soggybag/Ugly-Face-3-SMD/docs/v1.3 Envelope.md

# Ugly Face 3 v1.3: new envelope (design, 2026-10-16)

**Schematic: drawn (2026-10-16), rev 1.3, ERC 0.** Envelope detector at the top of ENVELOPE & GATE; U5B / Q1 / vactrol in the new VACTROL DRIVER box; D6 BAT54S on RESET; R21 15k; R13 220k. **PCB: updated 2026-10-19** (v1.1 layout kept; the envelope parts are added in the space freed by R7 / C8, mainly right of U2). Fully routed (46 vias), DRC 0 errors, parity clean; JLC files in `production/` (64 placements, 37 BOM lines). Also in v1.3: the Taiway 100 footprint with plated slots (v1.1 holes were too small for the flat lugs), R31/R32 on the Basic 100k (C149504).

**Before ordering:** the new envelope hasn't been breadboarded yet (see *Next step* below). The board follows the simulated design; the DECAY trimmer and C20 are the knobs to tune afterwards.

**Build notes (v1.3):**
- **RV6** (DECAY, 3362P 500k, front top-right): its leads come through under the MIX pot body on the back. Trim them flush, as for the vactrol and J1/J2.
- **Vactrol polarity:** U3 pin 1 = LED anode (long leg, to R35 / +9V), pin 2 = cathode (to Q1). v1.1 drove it the other way round from the pot.
- **R31, R32, R34** have no reference on the silkscreen (no room); see the interactive BOM.
- **JLC viewer:** check U1, U2, U4, U5 (SOIC-8) and D6, Q1 (SOT-23). Other boards this month needed SOIC op-amps turned 90° clockwise and SOT-23 transistors 180°. C1 / C4 already carry a 180° offset.
- **Extended parts:** TLC555 (C6987), 100µ C970685, BAT54S C19726 (new), R8 56k C17756 (was Basic; JLC moved it).

## Bench result (2026-10-23)

Built on a breadboard and wired to unit 1 (DRY_OUT tap = the same buffered dry signal v1.3 uses): **works**. C21 3.3µ sounded best (smoother envelope, less ripple on low notes, attack ~3 ms, DECAY range ~0.07–1.7 s). On the board: **C21 = 4.7µ 0805 X5R (C1779, same as C17)**, about 3µ at its 4.5–7 V DC bias. RV6 stays a trimmer (players may want to adjust DECAY). Also for v1.3: R8 56k → 47k (Basic; GLITCH trim point moves to ~60% of RV2). The pedal is renamed **FU-2**.

## Why the v1.1 envelope is weak

- The vactrol LED is fed from **PRE_OUT** (R7 100 Ω → C8 100µ → ENVELOPE RV1 B1k → LED), the ×201 preamp **after it clips**. Every note is the same ~7 Vpp square, so loudness information is mostly gone: what's left is how long a note keeps clipping.
- The LED only conducts on the positive half-cycle, and only above its ~1.8 V forward voltage. With the pot as a divider, nothing happens below ~50 % of the rotation.
- Bench tests (2026-10-15/16) of rewiring RV1 as a rheostat, with a diode or a 2k2 for C8's DC return: too strong or too weak. The drive itself has to change. Full background: `../Ugly Face Roadmap.md` → *Envelope: string balance*.

## New circuit (roadmap option A, simplified for UF3)

UF3 already has a **clean** copy of the guitar: **DRY_OUT** (U4A, ×4.3). The new envelope is taken from it, so the preamp and gate are untouched. One **LM358** and one transistor are added.

```
DRY_OUT ─ C20 33n ─ R26 10k ─┬─ RV1 pin 3          ENVELOPE = A10k level control (pin 1 to VB)
                             RV1 (A10k)             tilt: 33n with 20k → ~240 Hz high-pass
                     VB ─────┴─ RV1 pin 1           (evens out low E vs thin strings)
                 RV1 wiper ──► U5A +  (pin 3)

U5A: peak detector with gain ×22
   out (pin 1) ─ D5 1N4148W ─ R27 1k ─┬─ ENV ── C21 1µ ─ GND        attack ~1 ms
                                      ├─ R28 470k ─ U5A − (pin 2) ── R29 22k ─ VB
                                      └─ R30 22k ─ RV6 500k trim ─ VB        DECAY ~20–250 ms

U5B + Q1: current sink for the vactrol LED, I_LED ≈ 2.1 × (ENV − VB − 0.2 V) / 330 Ω
   ENV ─ U5B + (pin 5)
   U5B − (pin 6) ── R31 100k ─ +9V,  R36 1M ─ +9V,  R32 100k ─ Q1 emitter
   U5B out (pin 7) ─ R33 1k ─ Q1 base (MMBT3904)
   Q1 emitter ─ R34 330 ─ GND
   +9V ─ R35 100 ─ vactrol LED anode (U3 pin 1);  LED cathode (U3 pin 2) ─ Q1 collector
```

### How it works

- **Tilt:** C20 / R26 + RV1 form a ~240 Hz high-pass. That takes ~8–10 dB off the low E fundamental, so the thin strings drive the envelope about as hard as the low E. The 10k / 10k divider also halves the signal, keeping U5A's input inside the LM358's range on hard peaks.
- **ENVELOPE (RV1)** is now a level control in front of the detector. **Fully counter-clockwise = no envelope at all**; the A-taper gives an even feel across the rotation.
- **U5A** is a peak detector with gain (×22). It charges C21 quickly (R27 1k, ~1 ms) and **DECAY** (R30 + RV6 trimmer) lets it fall back to VB. Fast, short notes still register.
- **U5B + Q1** is a voltage-to-current converter. It compares ENV with +9V / 2 (ratiometric, the same as VB) and sinks LED current through Q1. A current drive has no 1.8 V dead zone, so small envelopes still light the LED.
  - **R36 1M** makes a deliberate ~0.2 V dead zone, so the LED is **fully off at rest** even with the LM358's worst-case offset (±7 mV × 22 gain).
- **Current limit:** the LM358's output tops out ~1.5 V below +9V, and Q1 runs out of headroom, so the LED current can't exceed ~15 mA. That's safe for the vactrol LED.
- **Bonus:** PRE_OUT no longer drives the LED, so the gate signal is cleaner.

### Simulation (`sim/envelope_v13.py`, ngspice)

- **Rest, no input:** LED current **0** with detector offset 0, +7 mV and −7 mV.
- **Decaying note at DRY_OUT** (peak LED mA / LED mA after 1.4 s):

| DRY_OUT peak (≈ guitar) | ENVELOPE max | ENVELOPE ~noon | ENVELOPE low |
|---|---|---|---|
| 0.2 V (~50 mV, soft), low E / high E | 3.7 / 9.0 mA | 0 / 1.0 | 0 / 0 |
| 1 V (~230 mV, medium) | 14.6 / 14.6 | 4.7 / 11.6 | 0 / 1.0 |
| 3 V (~700 mV, hard) | 14.8 / 14.7 | 13.8 / 14.6 | 2.7 / 6.5 |

- The full ENVELOPE rotation is useful, and fully down really is off.
- **Tilt:** with sine tests the high E gets about 2× the low E. Real low E notes are louder (pickup output) and rich in harmonics, so on a guitar they should come out roughly even. **Tune on the breadboard:** C20 33n → 68n is gentler, 22n is stronger.

## Parts (all JLC basic, except the pot and trimmer)

| Ref | Part | LCSC |
|---|---|---|
| U5 | LM358 SOIC-8 | C7950 |
| Q1 | MMBT3904 SOT-23 | C20526 |
| D5 | 1N4148W SOD-123 | C81598 |
| C20 | 33n 0805 | C1739 |
| C21 | 1µ 0805 | C28323 |
| C22 | 100n 0805 (U5 decoupling) | C49678 |
| R27, R33 | 1k | C17513 |
| R28 | 470k | C17709 |
| D6 | BAT54S (RESET clamp) | C19726 |
| R29, R30 | 22k | C17560 |
| R31, R32 | 100k | C17407 |
| R34 | 330 | C17630 |
| R35 | 100 | C17408 |
| R36 | 1M | C17514 |
| R26 | 10k | C17414 |
| RV1 | **A10k** 16 mm (was B1k) | hand-solder, Tayda |
| RV6 | 3362P 500k trimmer (DECAY) | hand-solder |

**Removed:** R7 100 Ω, C8 100µ.

**Rewired:** vactrol U3 pin 1 (LED anode) → R35 → +9V; U3 pin 2 (LED cathode) → Q1 collector (no longer GND).

## Other v1.3 changes (from v1.1 bench testing)

| Change | Status |
|---|---|
| R21 2k2 → **15k** (THR ON lets the guitar through) | Proven |
| R13 47k → **220k** (MIX balance) | Proven. Still leans to the fuzz side: try **330k** before v1.3 is ordered (see MIX below) |
| **BAT54S** RESET clamp (as UF1) | Proven on UF1 |
| C10 timing cap: film or C0G, retune FREQUENCY (low end 33 Hz is too low) | To do |

### MIX: would a tapered pot help?

- MIX (RV4 B10k) is a pan pot: each end shunts one side to VB.
- A taper doesn't change the levels at the two ends. It only moves **where** in the rotation the balance falls, and it crowds the other half of the travel.
- The imbalance is a level difference (and a square wave sounds louder than its level suggests), so the **resistor is the right fix**: R13 220k → 330k (or 470k). Keep RV4 B10k.
- Tack a 330k (or a 100k in series with the 220k) on unit 1 and listen. If noon sounds balanced, that's the v1.3 value.

## Next step: bench-test on unit 1 before the PCB

Build the new envelope on a small breadboard and wire it to the v1.1 board:

1. **Taps from the board:** **+9V** (C19 +, or U4 pin 8), **GND**, **VB** (U4 pin 7), **DRY_OUT** (U4 pin 1).
2. **Vactrol:** unsolder the LED leads (U3 pads 1 and 2) and run them to the breadboard (anode → R35, cathode → Q1 collector). **Leave the LDR on pads 3 and 4.**
3. Remove **R7** (or C8), so PRE_OUT no longer feeds the old LED path. The board's RV1 then does nothing; use an A10k (or any 10k) on the breadboard as ENVELOPE.
4. **Checks:**
   - At rest: ENV (C21) ≈ VB, LED current (V across R34 ÷ 330) ≈ 0, LED dark.
   - Pluck the low E and high E: watch ENV; the peaks should be similar.
   - Listen: ENVELOPE range, DECAY trimmer range vs the LDR's own lag, low E vs thin strings.
   - Try C20 22n / 33n / 68n.

Through-hole equivalents for the breadboard: LM358 DIP, 2N3904, 1N4148, ¼ W resistors.
