soggybag/Ugly-Face-3-SMD/UglyFace_03_render_bottom.png

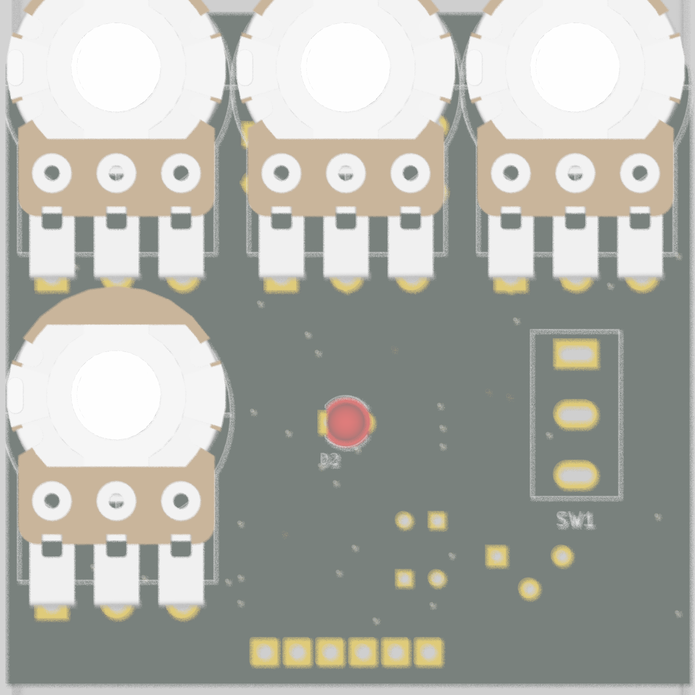
UglyFace_03_render_bottom.png
