soggybag/Ugly-Face-3-SMD/UglyFace_03_render_enclosure.png

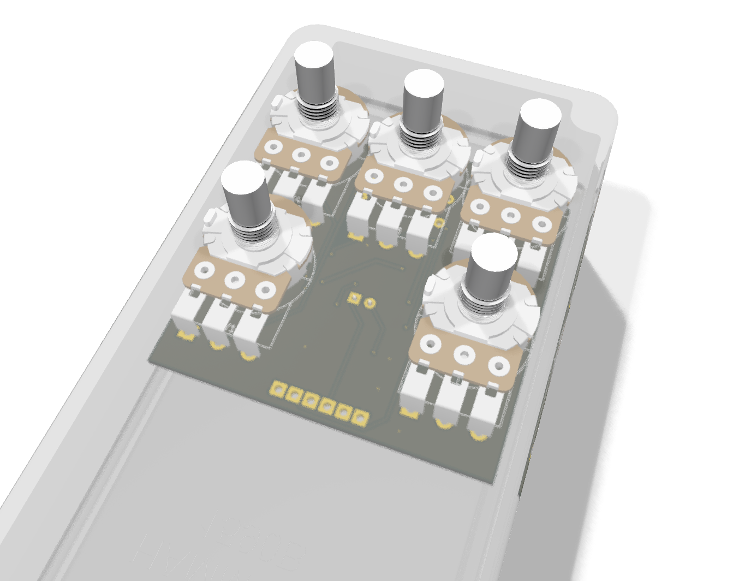
UglyFace_03_render_enclosure.png
