soggybag/Ugly-Face-3-SMD/archive/v1.3/parts.csv

Reference | Value | Footprint | Side | X mm | Y mm | Rotation | LCSC | Fitted by
C1 | 100u | Capacitor_SMD:CP_Elec_6.3x7.7 | front | 134.2 | 90.9 | 180.0 | C970685 | JLC
C2 | 100n | Capacitor_SMD:C_0805_2012Metric_Pad1.18x1.45mm_HandSolder | front | 136.96 | 116.8 | 180.0 | C49678 | JLC
C3 | 100n | Capacitor_SMD:C_0805_2012Metric_Pad1.18x1.45mm_HandSolder | front | 161.0 | 104.4 | 90.0 | C49678 | JLC
C4 | 100u | Capacitor_SMD:CP_Elec_6.3x7.7 | front | 145.3 | 105.0 | 0.0 | C970685 | JLC
C5 | 1n | Capacitor_SMD:C_0805_2012Metric_Pad1.18x1.45mm_HandSolder | front | 126.56 | 104.5 | 180.0 | C46653 | JLC
C6 | 10n | Capacitor_SMD:C_0805_2012Metric_Pad1.18x1.45mm_HandSolder | front | 135.16 | 104.3 | 0.0 | C1710 | JLC
C7 | 2.2u | Capacitor_SMD:C_0805_2012Metric_Pad1.18x1.45mm_HandSolder | front | 147.08 | 122.14 | 0.0 | C377773 | JLC
C9 | 2.2u | Capacitor_SMD:C_1206_3216Metric_Pad1.33x1.80mm_HandSolder | front | 126.6 | 116.26 | -90.0 | C50254 | JLC
C10 | 470n | Capacitor_SMD:C_0805_2012Metric_Pad1.18x1.45mm_HandSolder | front | 151.7 | 95.6 | 0.0 | C13967 | JLC
C11 | 10n | Capacitor_SMD:C_0805_2012Metric_Pad1.18x1.45mm_HandSolder | front | 161.0 | 108.6 | 90.0 | C1710 | JLC
C12 | 1u | Capacitor_SMD:C_0805_2012Metric_Pad1.18x1.45mm_HandSolder | front | 171.7 | 105.34 | -90.0 | C28323 | JLC
C13 | 1u | Capacitor_SMD:C_0805_2012Metric_Pad1.18x1.45mm_HandSolder | front | 165.36 | 92.8 | 0.0 | C28323 | JLC
C14 | 220p | Capacitor_SMD:C_0805_2012Metric_Pad1.18x1.45mm_HandSolder | front | 142.84 | 114.8 | 180.0 | C107145 | JLC
C15 | 100n | Capacitor_SMD:C_0805_2012Metric_Pad1.18x1.45mm_HandSolder | front | 158.0 | 120.9 | 90.0 | C49678 | JLC
C16 | 10u | Capacitor_SMD:C_0805_2012Metric_Pad1.18x1.45mm_HandSolder | front | 126.0 | 90.19 | -90.0 | C15850 | JLC
C17 | 4.7u | Capacitor_SMD:C_0805_2012Metric_Pad1.18x1.45mm_HandSolder | front | 155.85 | 122.6 | 90.0 | C1779 | JLC
C18 | 22u | Capacitor_SMD:C_1206_3216Metric_Pad1.33x1.80mm_HandSolder | front | 154.0 | 113.0 | 0.0 | C12891 | JLC
C19 | 100n | Capacitor_SMD:C_0805_2012Metric_Pad1.18x1.45mm_HandSolder | front | 152.0 | 115.4 | 0.0 | C49678 | JLC
C20 | 33n | Capacitor_SMD:C_0805_2012Metric_Pad1.18x1.45mm_HandSolder | front | 146.72 | 118.7 | -90.0 | C1739 | JLC
C21 | 4.7u | Capacitor_SMD:C_0805_2012Metric_Pad1.18x1.45mm_HandSolder | front | 162.22 | 120.7 | 180.0 | C1779 | JLC
C22 | 100n | Capacitor_SMD:C_0805_2012Metric_Pad1.18x1.45mm_HandSolder | front | 167.0 | 104.0 | 180.0 | C49678 | JLC
D1 | SS14 | Diode_SMD:D_SMA_Handsoldering | front | 134.1 | 82.5 | 0.0 | C2480 | JLC
D2 | LED | LED_THT:LED_D3.0mm | back | 149.94 | 110.71 | 180.0 |  | hand
D3 | 1N4148/LED | UglyFace:D_THT_Standing_3mm_P2.54_Compact | front | 141.65 | 118.3 | 0.0 |  | hand
D4 | 1N4148/LED | UglyFace:D_THT_Standing_3mm_P2.54_Compact | front | 144.19 | 122.8 | 180.0 |  | hand
D5 | 1N4148W | Diode_SMD:D_SOD-123 | front | 169.22 | 113.45 | 90.0 | C81598 | JLC
D6 | BAT54S | Package_TO_SOT_SMD:SOT-23 | front | 158.72 | 112.95 | -90.0 | C19726 | JLC
J1 | 9V | Connector_Wire:SolderWire-0.5sqmm_1x01_D0.9mm_OD2.1mm | front | 143.7 | 81.86 | 0.0 |  | hand
J2 | 9V GND | Connector_Wire:SolderWire-0.5sqmm_1x01_D0.9mm_OD2.1mm | front | 148.3 | 81.86 | 0.0 |  | hand
J3 | IN | Connector_Wire:SolderWire-0.5sqmm_1x01_D0.9mm_OD2.1mm | front | 144.86 | 128.49 | 0.0 |  | hand
J4 | IN GND | Connector_Wire:SolderWire-0.5sqmm_1x01_D0.9mm_OD2.1mm | front | 142.32 | 128.49 | 0.0 |  | hand
J5 | OUT | Connector_Wire:SolderWire-0.5sqmm_1x01_D0.9mm_OD2.1mm | front | 152.48 | 128.49 | 0.0 |  | hand
J6 | OUT GND | Connector_Wire:SolderWire-0.5sqmm_1x01_D0.9mm_OD2.1mm | front | 155.02 | 128.49 | 0.0 |  | hand
J7 | LED - | Connector_Wire:SolderWire-0.5sqmm_1x01_D0.9mm_OD2.1mm | front | 147.4 | 128.49 | 0.0 |  | hand
J8 | LED GND | Connector_Wire:SolderWire-0.5sqmm_1x01_D0.9mm_OD2.1mm | front | 149.94 | 128.49 | 0.0 |  | hand
Q1 | MMBT3904 | Package_TO_SOT_SMD:SOT-23 | front | 164.22 | 112.95 | 90.0 | C20526 | JLC
R1 | 10k | Resistor_SMD:R_0805_2012Metric_Pad1.20x1.40mm_HandSolder | front | 139.75 | 97.25 | 90.0 | C17414 | JLC
R2 | 10k | Resistor_SMD:R_0805_2012Metric_Pad1.20x1.40mm_HandSolder | front | 139.75 | 101.5 | 90.0 | C17414 | JLC
R3 | 1M | Resistor_SMD:R_0805_2012Metric_Pad1.20x1.40mm_HandSolder | front | 126.5 | 109.1 | 0.0 | C17514 | JLC
R4 | 1M | Resistor_SMD:R_0805_2012Metric_Pad1.20x1.40mm_HandSolder | front | 128.5 | 102.0 | 0.0 | C17514 | JLC
R5 | 200k | Resistor_SMD:R_0805_2012Metric_Pad1.20x1.40mm_HandSolder | front | 135.3 | 106.5 | 0.0 | C17539 | JLC
R6 | 1k | Resistor_SMD:R_0805_2012Metric_Pad1.20x1.40mm_HandSolder | front | 136.0 | 114.5 | 0.0 | C17513 | JLC
R8 | 47k | Resistor_SMD:R_0805_2012Metric_Pad1.20x1.40mm_HandSolder | front | 126.9 | 120.6 | 0.0 | C17713 | JLC
R9 | 1k | Resistor_SMD:R_0805_2012Metric_Pad1.20x1.40mm_HandSolder | front | 139.6 | 121.0 | 90.0 | C17513 | JLC
R10 | 470 | Resistor_SMD:R_0805_2012Metric_Pad1.20x1.40mm_HandSolder | front | 144.5 | 95.5 | 0.0 | C17710 | JLC
R11 | 100k | Resistor_SMD:R_0805_2012Metric_Pad1.20x1.40mm_HandSolder | front | 172.4 | 113.5 | 90.0 | C149504 | JLC
R12 | 15k | Resistor_SMD:R_0805_2012Metric_Pad1.20x1.40mm_HandSolder | front | 161.0 | 90.6 | 90.0 | C17475 | JLC
R13 | 220k | Resistor_SMD:R_0805_2012Metric_Pad1.20x1.40mm_HandSolder | front | 170.9 | 94.1 | 0.0 | C17556 | JLC
R14 | 15k | Resistor_SMD:R_0805_2012Metric_Pad1.20x1.40mm_HandSolder | front | 165.7 | 89.5 | 0.0 | C17475 | JLC
R15 | 15k | Resistor_SMD:R_0805_2012Metric_Pad1.20x1.40mm_HandSolder | front | 170.9 | 90.2 | 90.0 | C17475 | JLC
R16 | 47k | Resistor_SMD:R_0805_2012Metric_Pad1.20x1.40mm_HandSolder | front | 142.7 | 110.6 | -90.0 | C17713 | JLC
R17 | 15k | Resistor_SMD:R_0805_2012Metric_Pad1.20x1.40mm_HandSolder | front | 147.08 | 114.52 | 180.0 | C17475 | JLC
R18 | 100 | Resistor_SMD:R_0805_2012Metric_Pad1.20x1.40mm_HandSolder | front | 126.0 | 94.8 | 90.0 | C17408 | JLC
R19 | 2k | Resistor_SMD:R_0805_2012Metric_Pad1.20x1.40mm_HandSolder | front | 157.0 | 83.4 | 0.0 | C17604 | JLC
R20 | 1k | Resistor_SMD:R_0805_2012Metric_Pad1.20x1.40mm_HandSolder | front | 123.9 | 125.5 | 90.0 | C17513 | JLC
R21 | 15k | Resistor_SMD:R_0805_2012Metric_Pad1.20x1.40mm_HandSolder | front | 126.4 | 125.5 | 90.0 | C17475 | JLC
R22 | 22k | Resistor_SMD:R_0805_2012Metric_Pad1.20x1.40mm_HandSolder | front | 128.9 | 125.5 | 90.0 | C17560 | JLC
R23 | 47 | Resistor_SMD:R_0805_2012Metric_Pad1.20x1.40mm_HandSolder | front | 153.3 | 110.5 | 0.0 | C17714 | JLC
R24 | 33k | Resistor_SMD:R_0805_2012Metric_Pad1.20x1.40mm_HandSolder | front | 152.0 | 125.4 | 0.0 | C17633 | JLC
R25 | 10k | Resistor_SMD:R_0805_2012Metric_Pad1.20x1.40mm_HandSolder | front | 155.85 | 118.5 | 90.0 | C17414 | JLC
R26 | 10k | Resistor_SMD:R_0805_2012Metric_Pad1.20x1.40mm_HandSolder | front | 158.22 | 125.2 | -90.0 | C17414 | JLC
R27 | 1k | Resistor_SMD:R_0805_2012Metric_Pad1.20x1.40mm_HandSolder | front | 168.22 | 120.95 | 180.0 | C17513 | JLC
R28 | 470k | Resistor_SMD:R_0805_2012Metric_Pad1.20x1.40mm_HandSolder | front | 165.97 | 115.95 | 0.0 | C17709 | JLC
R29 | 22k | Resistor_SMD:R_0805_2012Metric_Pad1.20x1.40mm_HandSolder | front | 165.22 | 118.95 | -90.0 | C17560 | JLC
R30 | 22k | Resistor_SMD:R_0805_2012Metric_Pad1.20x1.40mm_HandSolder | front | 160.47 | 86.45 | 90.0 | C17560 | JLC
R31 | 100k | Resistor_SMD:R_0805_2012Metric_Pad1.20x1.40mm_HandSolder | front | 172.22 | 118.95 | 180.0 | C149504 | JLC
R32 | 100k | Resistor_SMD:R_0805_2012Metric_Pad1.20x1.40mm_HandSolder | front | 168.22 | 118.95 | 180.0 | C149504 | JLC
R33 | 1k | Resistor_SMD:R_0805_2012Metric_Pad1.20x1.40mm_HandSolder | front | 169.97 | 116.95 | 180.0 | C17513 | JLC
R34 | 330 | Resistor_SMD:R_0805_2012Metric_Pad1.20x1.40mm_HandSolder | front | 166.97 | 112.95 | 90.0 | C17630 | JLC
R35 | 100 | Resistor_SMD:R_0805_2012Metric_Pad1.20x1.40mm_HandSolder | front | 153.72 | 83.95 | -90.0 | C17408 | JLC
R36 | 1M | Resistor_SMD:R_0805_2012Metric_Pad1.20x1.40mm_HandSolder | front | 172.22 | 120.95 | 180.0 | C17514 | JLC
RV1 | A10k | UglyFace:Potentiometer_Alpha_16mm_Vertical | front | 166.45 | 124.68 | 0.0 |  | hand
RV2 | 10k | UglyFace:Potentiometer_Bourns_3362P_Vertical | front | 134.5 | 123.6 | 180.0 |  | hand
RV3 | C100k | UglyFace:Potentiometer_Alpha_16mm_Vertical | front | 148.67 | 99.28 | 0.0 |  | hand
RV4 | B10k | UglyFace:Potentiometer_Alpha_16mm_Vertical | front | 166.45 | 99.28 | 0.0 |  | hand
RV5 | A100k | UglyFace:Potentiometer_Alpha_16mm_Vertical | front | 130.89 | 99.28 | 0.0 |  | hand
RV6 | 500k | UglyFace:Potentiometer_Bourns_3362P_Vertical | front | 165.52 | 84.45 | -90.0 |  | hand
SW1 | THR | UglyFace:SW_Taiway_100_SPDT_PC | back | 130.89 | 110.08 | 0.0 |  | hand
U1 | TL072 | Package_SO:SOIC-8_3.9x4.9mm_P1.27mm | front | 136.82 | 110.5 | 0.0 | C6961 | JLC
U2 | TLC555 | Package_SO:SOIC-8_3.9x4.9mm_P1.27mm | front | 155.6 | 106.5 | 0.0 | C6987 | JLC
U3 | Vactrol | UglyFace:Vactrol_LED_LDR_DIY | front | 148.8 | 90.3 | 0.0 |  | hand
U4 | TL072 | Package_SO:SOIC-8_3.9x4.9mm_P1.27mm | front | 152.0 | 120.3 | 90.0 | C6961 | JLC
U5 | LM358 | Package_SO:SOIC-8_3.9x4.9mm_P1.27mm | front | 167.0 | 108.0 | 0.0 | C7950 | JLC
