soggybag/Ugly-Face-3-SMD/3dmodels/1590B.stp

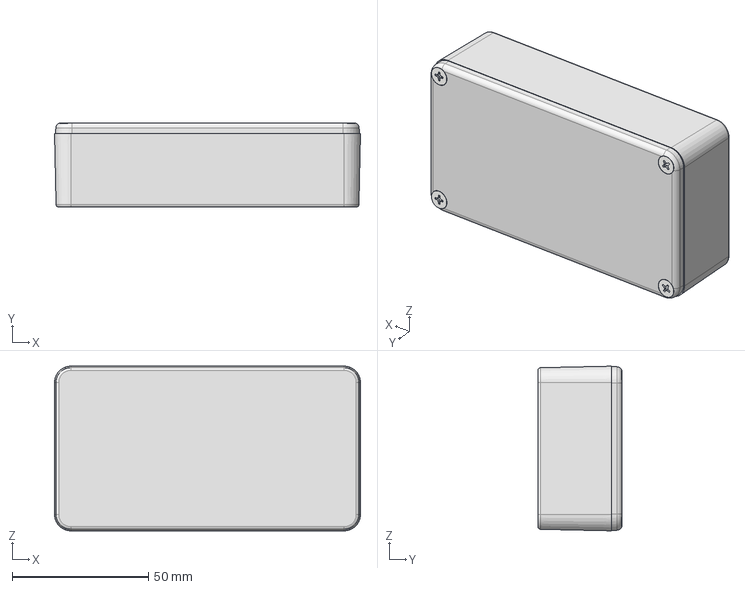
[picture p6: CAD file, 2026-10-03]
3dmodels/1590B.stp
112.4 x 31.0 x 60.5 mm
