soggybag/Ugly-Face-3-SMD/UglyFace_03_schematic.pdf

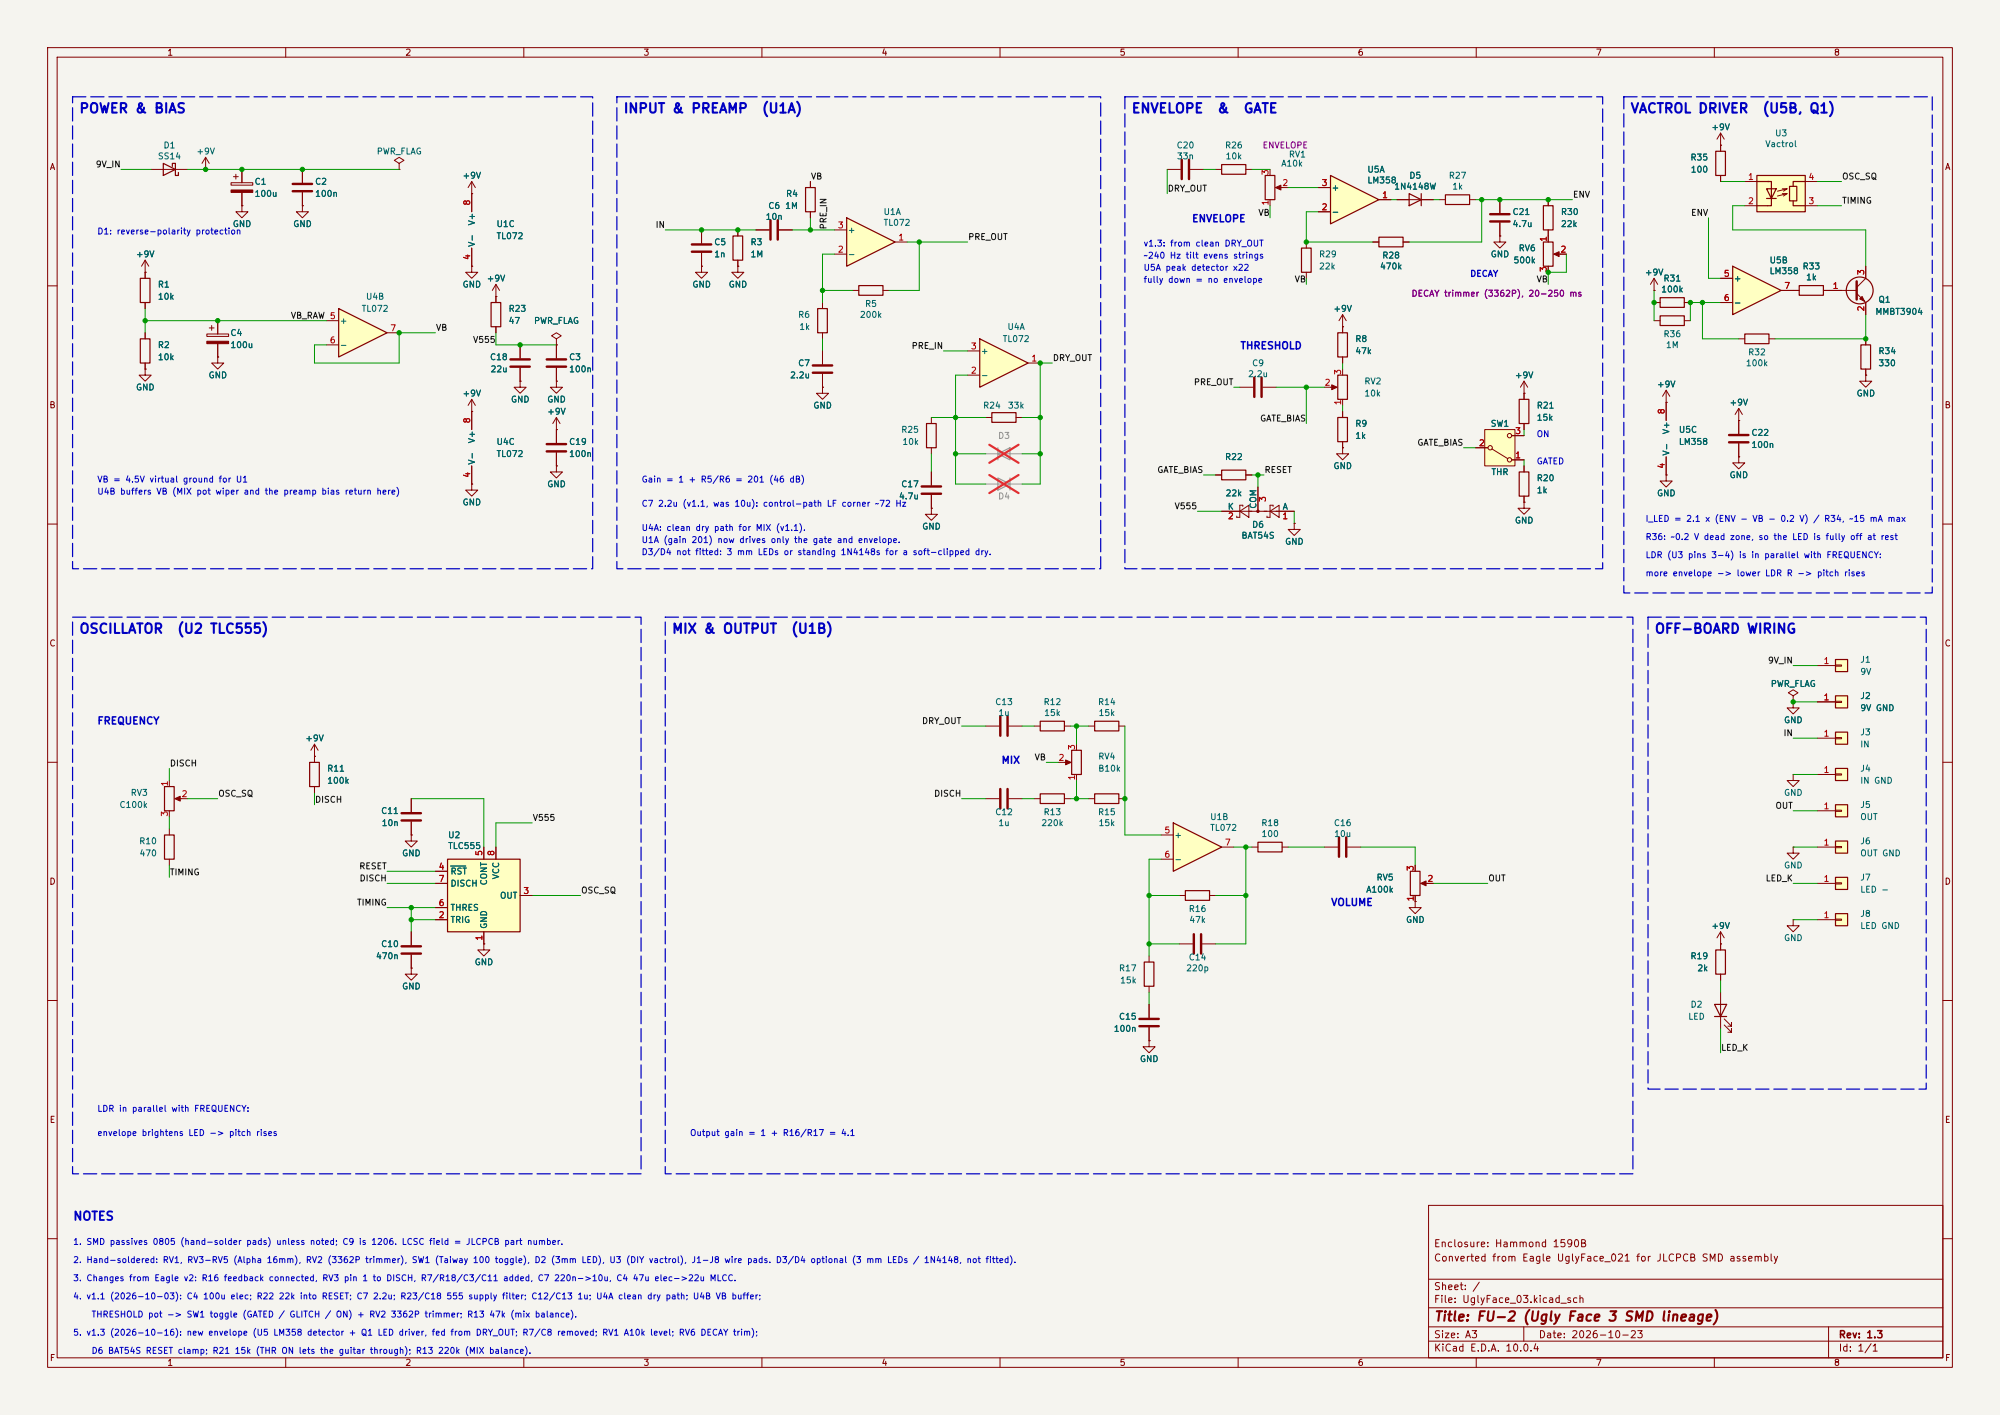
[picture p7: page 1]

LDR (U3 pins 3-4) is in parallel with FREQUENCY: VACTROL DRIVER (U5B, Q1)

v1.3: from clean DRY_OUT U5A peak detector x22

~240 Hz tilt evens strings U4B buffers VB (MIX pot wiper and the preamp bias return here)

fully down = no envelope

Output gain = 1 + R16/R17 = 4.1 MIX & OUTPUT (U1B)

C7 2.2u (v1.1, was 10u): control-path LF corner ~72 Hz GND

I_LED = 2.1 x (ENV - VB - 0.2 V) / R34, ~15 mA max more envelope -> lower LDR R -> pitch rises R36: ~0.2 V dead zone, so the LED is fully off at rest

LDR in parallel with FREQUENCY: D6 BAT54S RESET clamp; R21 15k (THR ON lets the guitar through); R13 220k (MIX balance).

envelope brightens LED -> pitch rises 1. SMD passives 0805 (hand-solder pads) unless noted; C9 is 1206. LCSC field = JLCPCB part number.

Enclosure: Hammond 1590B
Converted from Eagle UglyFace_021 for JLCPCB SMD assembly

3. Changes from Eagle v2: R16 feedback connected, RV3 pin 1 to DISCH, R7/R18/C3/C11 added, C7 220n->10u, C4 47u elec->22u MLCC. 5. v1.3 (2026-10-16): new envelope (U5 LM358 detector + Q1 LED driver, fed from DRY_OUT; R7/C8 removed; RV1 A10k level; RV6 DECAY trim); 2. Hand-soldered: RV1, RV3-RV5 (Alpha 16mm), RV2 (3362P trimmer), SW1 (Taiway 100 toggle), D2 (3mm LED), U3 (DIY vactrol), J1-J8 wire pads. D3/D4 optional (3 mm LEDs / 1N4148, not fitted). 4. v1.1 (2026-10-03): C4 100u elec; R22 22k into RESET; C7 2.2u; R23/C18 555 supply filter; C12/C13 1u; U4A clean dry path; U4B VB buffer;

Sheet: /
File: UglyFace_03.kicad_sch
Title: FU-2 (Ugly Face 3 SMD lineage)

THRESHOLD pot -> SW1 toggle (GATED / GLITCH / ON) + RV2 3362P trimmer; R13 47k (mix balance).

Size: A3 | Rev: 1.3
KiCad E.D.A. 10.0.4 | Id: 1/1 | F Date: 2026-10-23
