soggybag/Ugly-Face-3-SMD/Print.pdf

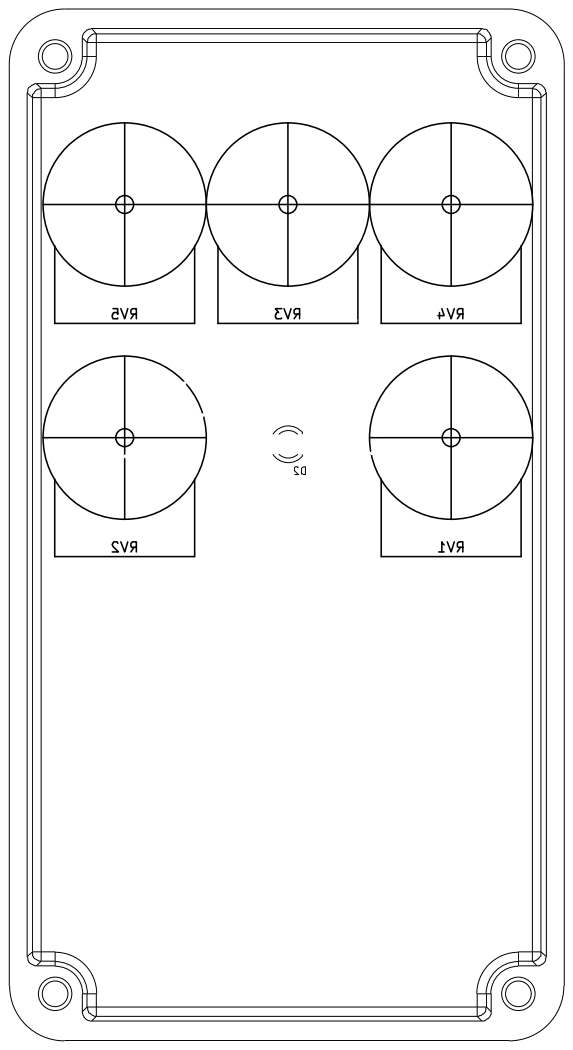
[picture p8: page 1]
