soggybag/Ugly-Face-3-SMD/archive/v1.3/UglyFace_03_board_back.pdf

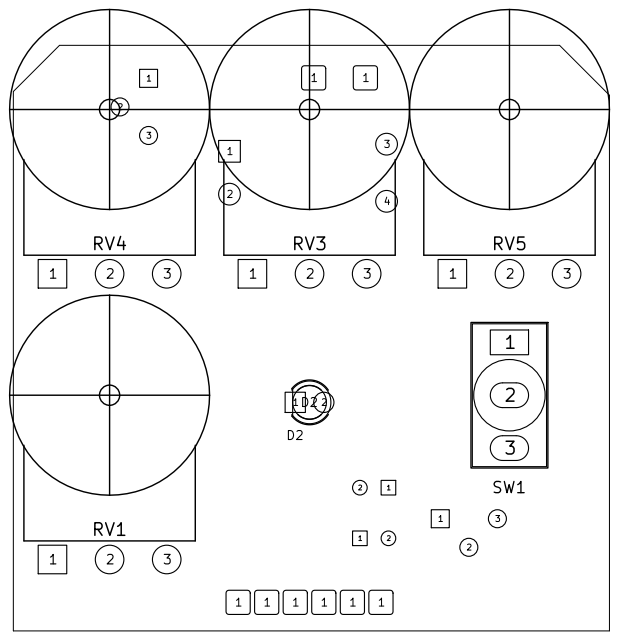
[picture p15: page 1]

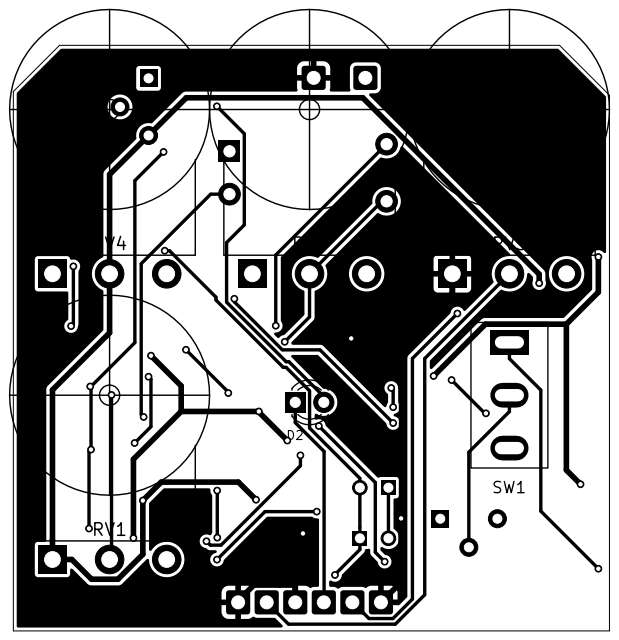
[picture p16: page 2]
