soggybag/Ugly-Face-3-SMD/archive/v1.3/UglyFace_03_board_front.pdf

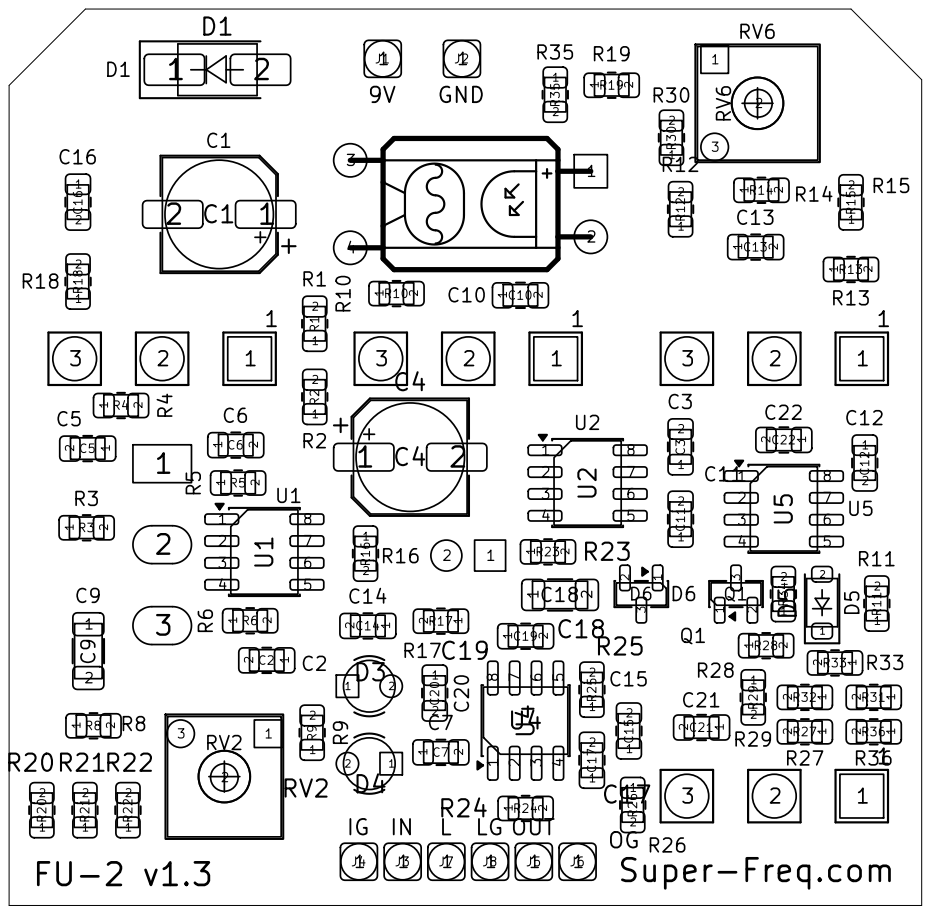
[picture p17: page 1]

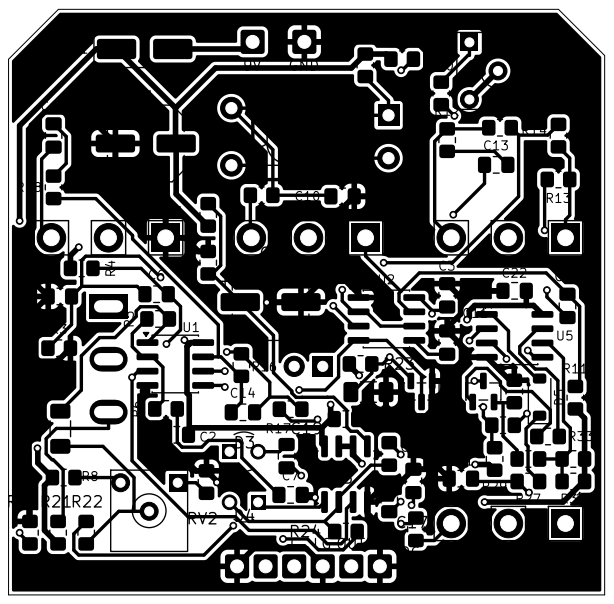
[picture p18: page 2]
