soggybag/Ugly-Face-3-SMD/archive/v1.0/UglyFace_03_board_back.pdf

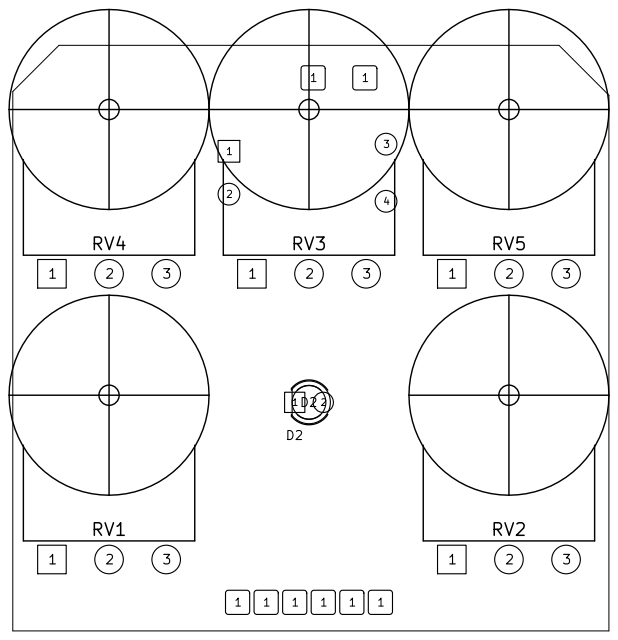
[picture p19: page 1]

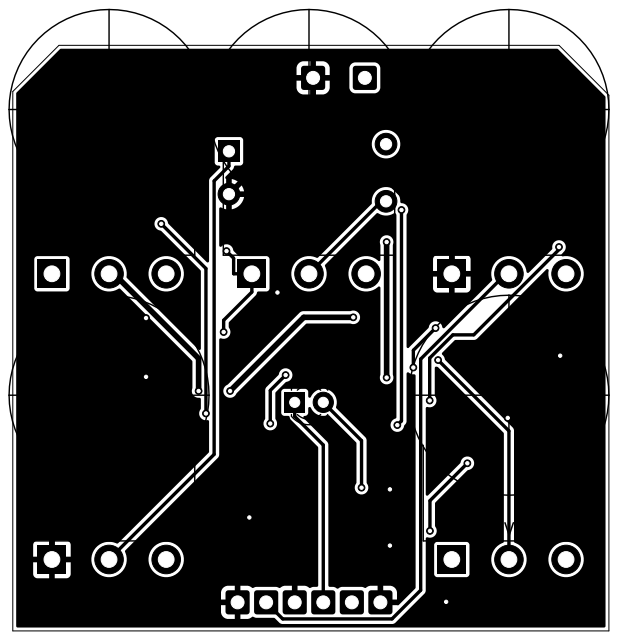
[picture p20: page 2]
