soggybag/Ugly-Face-3-SMD/archive/v1.0/UglyFace_03_board_front.pdf

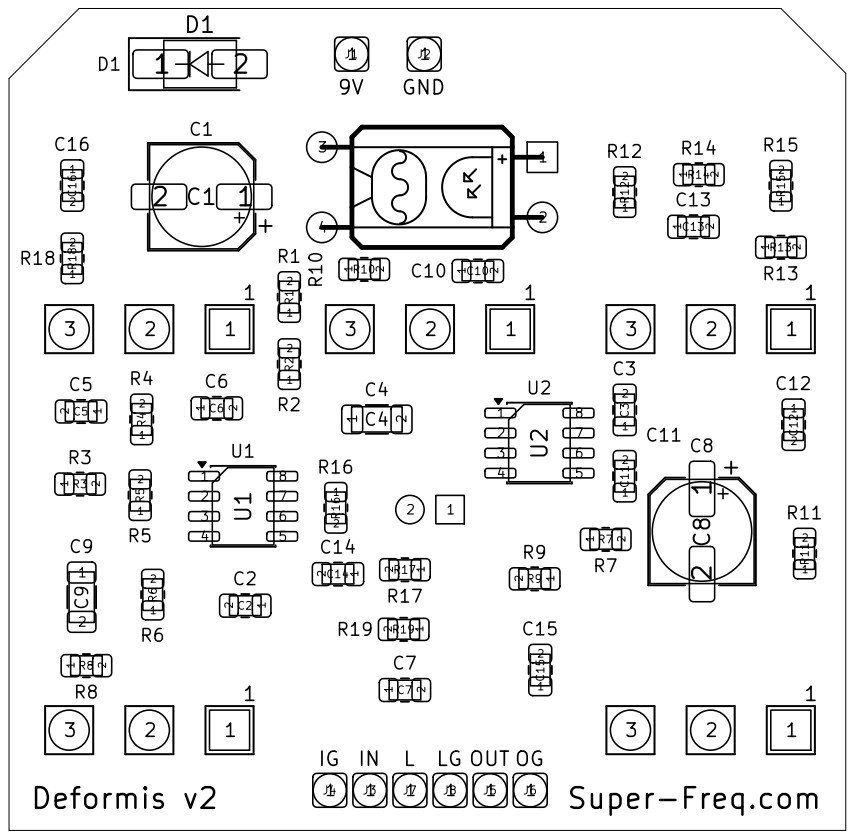
[picture p21: page 1]

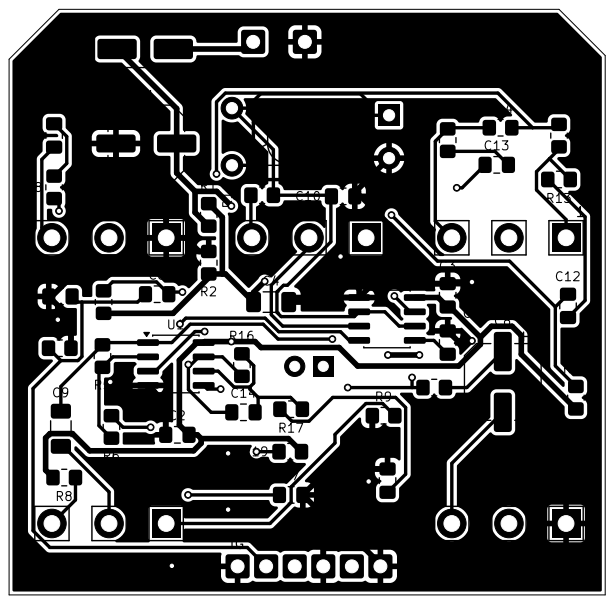
[picture p22: page 2]
