soggybag/Ugly-Face-3-SMD/archive/v1.1/UglyFace_03_board_back.pdf

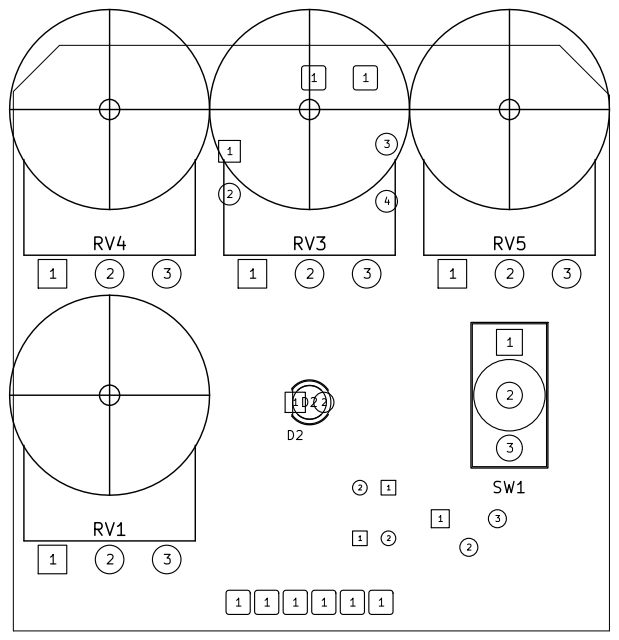
[picture p23: page 1]

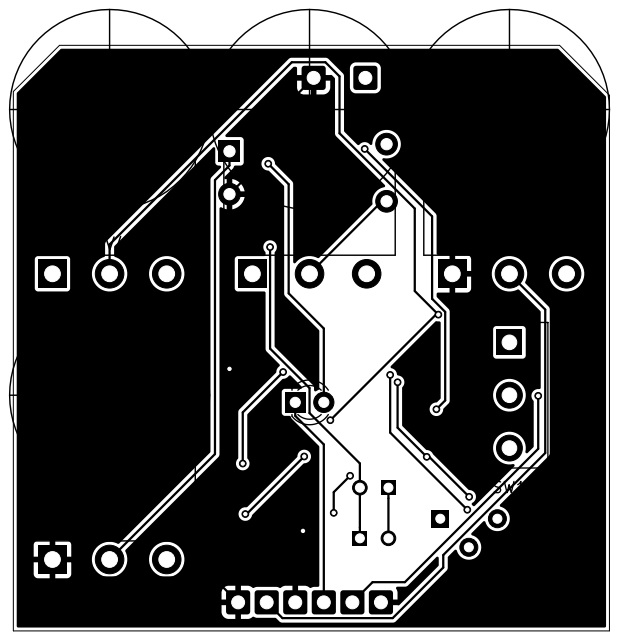
[picture p24: page 2]
