soggybag/Ugly-Face-3-SMD/archive/v1.1/UglyFace_03_board_front.pdf

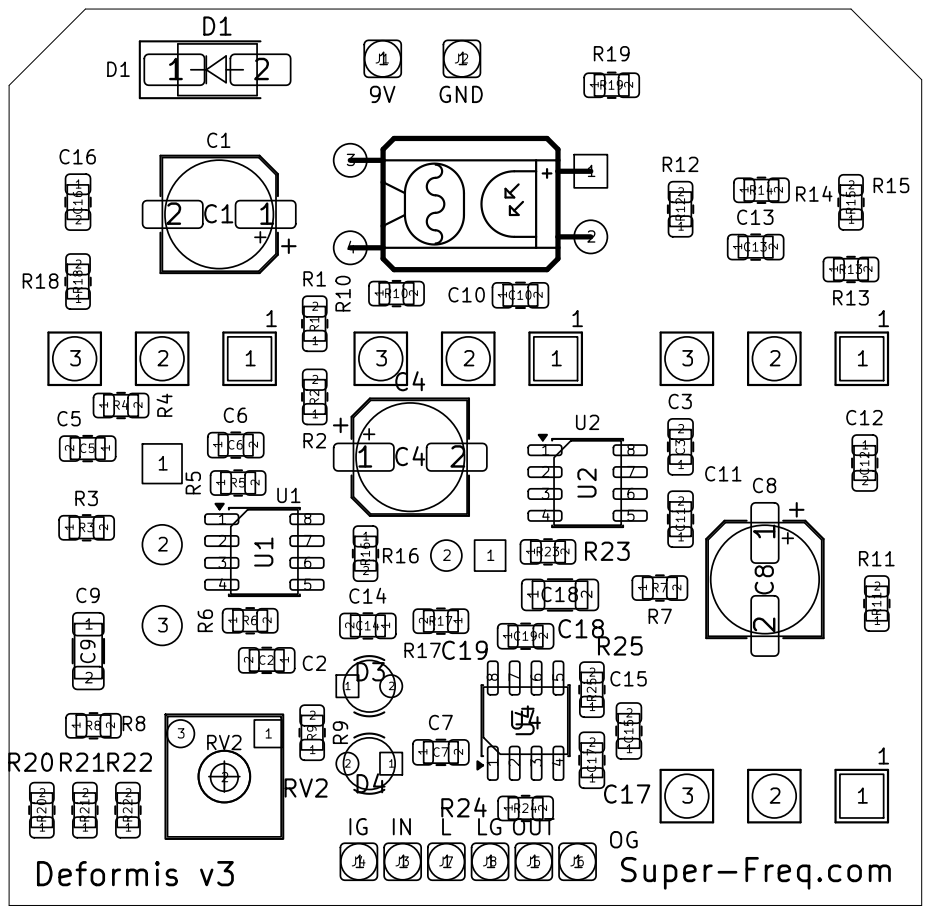
[picture p25: page 1]

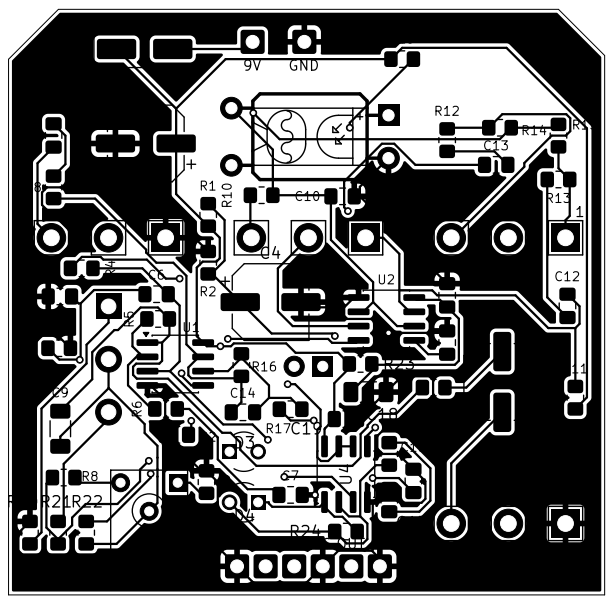
[picture p26: page 2]
