soggybag/Ugly-Face-3-SMD/UglyFace_03.kicad_pcb

## KiCad design UglyFace_03.kicad_pcb (2026-10-24)

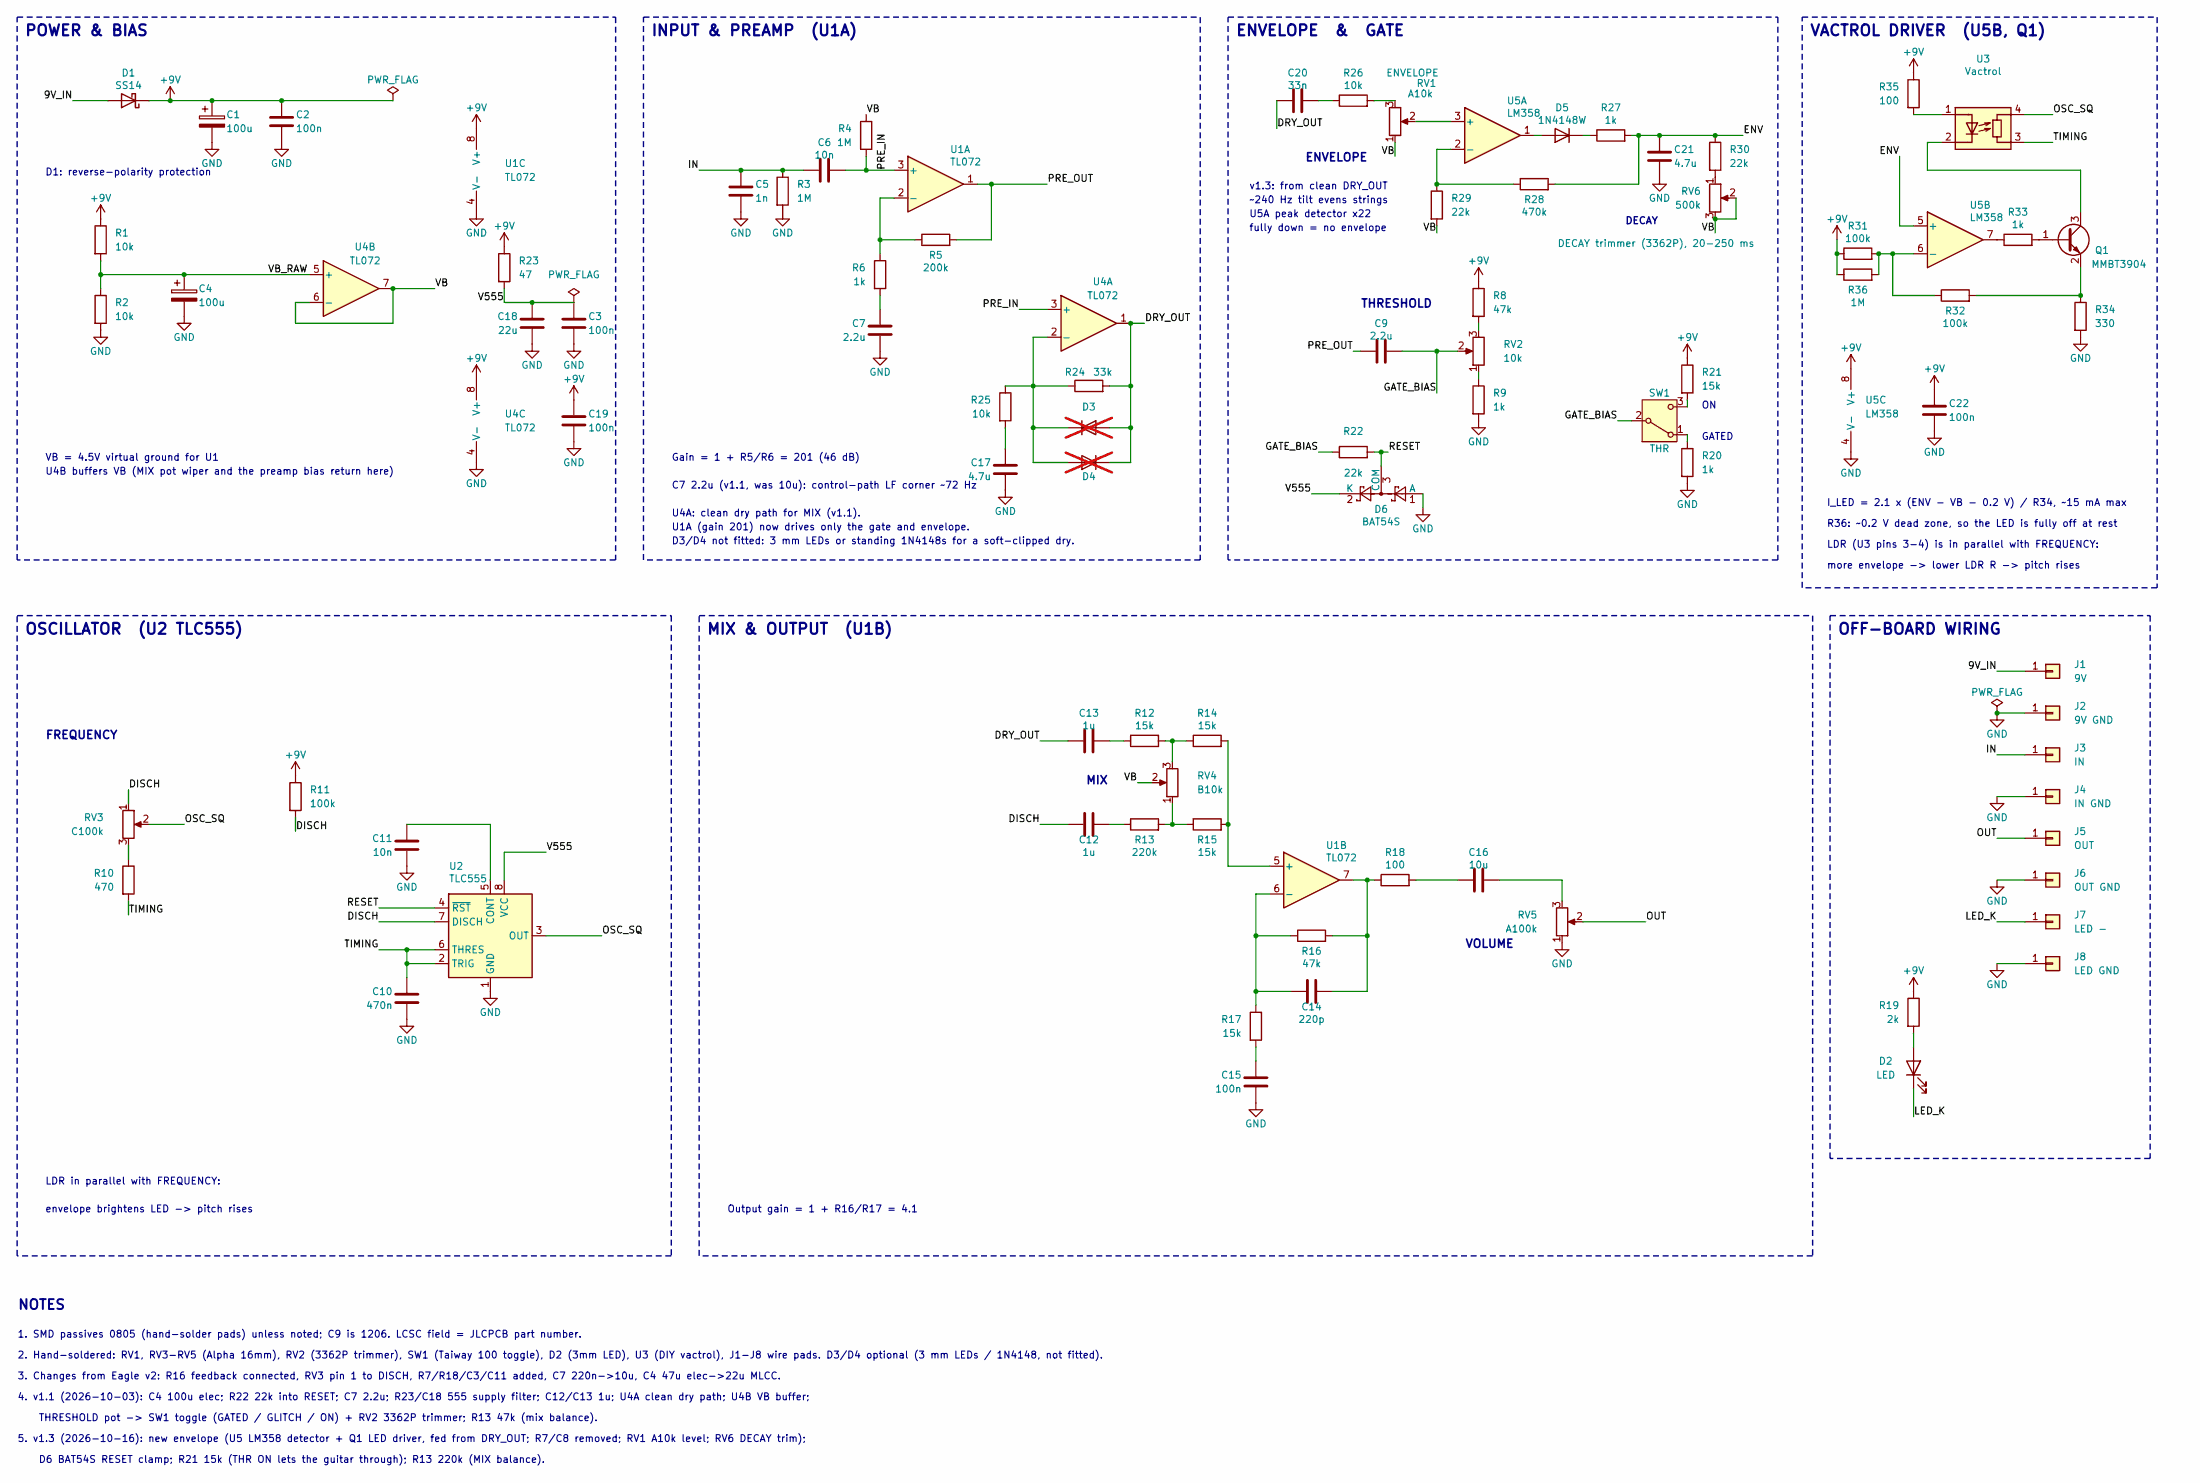
[picture p27: schematic UglyFace_03.kicad_sch, FU-2 (Ugly Face 3 SMD lineage)]

Parts:
C1, C4: 100u; CP_Elec_6.3x7.7; LCSC C970685
C2, C3, C15, C19, C22: 100n; C_0805_2012Metric_Pad1.18x1.45mm_HandSolder; LCSC C49678
C5: 1n; C_0805_2012Metric_Pad1.18x1.45mm_HandSolder; LCSC C46653
C6, C11: 10n; C_0805_2012Metric_Pad1.18x1.45mm_HandSolder; LCSC C1710
C7: 2.2u; C_0805_2012Metric_Pad1.18x1.45mm_HandSolder; LCSC C377773
C9: 2.2u; C_1206_3216Metric_Pad1.33x1.80mm_HandSolder; LCSC C50254
C10: 470n; C_0805_2012Metric_Pad1.18x1.45mm_HandSolder; LCSC C13967
C12, C13: 1u; C_0805_2012Metric_Pad1.18x1.45mm_HandSolder; LCSC C28323
C14: 220p; C_0805_2012Metric_Pad1.18x1.45mm_HandSolder; LCSC C107145
C16: 10u; C_0805_2012Metric_Pad1.18x1.45mm_HandSolder; LCSC C15850
C17, C21: 4.7u; C_0805_2012Metric_Pad1.18x1.45mm_HandSolder; LCSC C1779
C18: 22u; C_1206_3216Metric_Pad1.33x1.80mm_HandSolder; LCSC C12891
C20: 33n; C_0805_2012Metric_Pad1.18x1.45mm_HandSolder; LCSC C1739
D1: SS14; D_SMA_Handsoldering; LCSC C2480
D2: LED; LED_D3.0mm
D3, D4: 1N4148/LED; D_THT_Standing_3mm_P2.54_Compact; not fitted
D5: 1N4148W; D_SOD-123; LCSC C81598
D6: BAT54S; SOT-23; LCSC C19726
J1: 9V; SolderWire-0.5sqmm_1x01_D0.9mm_OD2.1mm
J2: 9V GND; SolderWire-0.5sqmm_1x01_D0.9mm_OD2.1mm
J3: IN; SolderWire-0.5sqmm_1x01_D0.9mm_OD2.1mm
J4: IN GND; SolderWire-0.5sqmm_1x01_D0.9mm_OD2.1mm
J5: OUT; SolderWire-0.5sqmm_1x01_D0.9mm_OD2.1mm
J6: OUT GND; SolderWire-0.5sqmm_1x01_D0.9mm_OD2.1mm
J7: LED -; SolderWire-0.5sqmm_1x01_D0.9mm_OD2.1mm
J8: LED GND; SolderWire-0.5sqmm_1x01_D0.9mm_OD2.1mm
Q1: MMBT3904; SOT-23; LCSC C20526
R1, R2, R25, R26: 10k; R_0805_2012Metric_Pad1.20x1.40mm_HandSolder; LCSC C17414
R3, R4, R36: 1M; R_0805_2012Metric_Pad1.20x1.40mm_HandSolder; LCSC C17514
R5: 200k; R_0805_2012Metric_Pad1.20x1.40mm_HandSolder; LCSC C17539
R6, R9, R20, R27, R33: 1k; R_0805_2012Metric_Pad1.20x1.40mm_HandSolder; LCSC C17513
R8, R16: 47k; R_0805_2012Metric_Pad1.20x1.40mm_HandSolder; LCSC C17713
R10: 470; R_0805_2012Metric_Pad1.20x1.40mm_HandSolder; LCSC C17710
R11, R31, R32: 100k; R_0805_2012Metric_Pad1.20x1.40mm_HandSolder; LCSC C149504
R12, R14, R15, R17, R21: 15k; R_0805_2012Metric_Pad1.20x1.40mm_HandSolder; LCSC C17475
R13: 220k; R_0805_2012Metric_Pad1.20x1.40mm_HandSolder; LCSC C17556
R18, R35: 100; R_0805_2012Metric_Pad1.20x1.40mm_HandSolder; LCSC C17408
R19: 2k; R_0805_2012Metric_Pad1.20x1.40mm_HandSolder; LCSC C17604
R22, R29, R30: 22k; R_0805_2012Metric_Pad1.20x1.40mm_HandSolder; LCSC C17560
R23: 47; R_0805_2012Metric_Pad1.20x1.40mm_HandSolder; LCSC C17714
R24: 33k; R_0805_2012Metric_Pad1.20x1.40mm_HandSolder; LCSC C17633
R28: 470k; R_0805_2012Metric_Pad1.20x1.40mm_HandSolder; LCSC C17709
R34: 330; R_0805_2012Metric_Pad1.20x1.40mm_HandSolder; LCSC C17630
RV1: A10k; Potentiometer_Alpha_16mm_Vertical
RV2: 10k; Potentiometer_Bourns_3362P_Vertical
RV3: C100k; Potentiometer_Alpha_16mm_Vertical
RV4: B10k; Potentiometer_Alpha_16mm_Vertical
RV5: A100k; Potentiometer_Alpha_16mm_Vertical
RV6: 500k; Potentiometer_Bourns_3362P_Vertical
SW1: THR; SW_Taiway_100_SPDT_PC
U1, U4: TL072; SOIC-8_3.9x4.9mm_P1.27mm; LCSC C6961
U2: TLC555; SOIC-8_3.9x4.9mm_P1.27mm; LCSC C6987
U3: Vactrol; Vactrol_LED_LDR_DIY
U5: LM358; SOIC-8_3.9x4.9mm_P1.27mm; LCSC C7950

Connections:
/9V_IN: D1.2 (A), J1.1
/DISCH: C12.1, R11.2, RV3.1, U2.7 (DISCH)
/DRY_OUT: C13.1, C20.1, D3.2 (A), D4.1 (K), R24.2, U4.1
/ENV: C21.1, R27.2, R28.2, R30.1, U5.5 (+)
/GATE_BIAS: C9.2, R22.1, RV2.2, SW1.2 (B)
/IN: C5.1, C6.1, J3.1, R3.1
/LED_K: D2.1 (K), J7.1
/OSC_SQ: RV3.2, U2.3 (OUT), U3.4 (R)
/OUT: J5.1, RV5.2
/PRE_IN: C6.2, R4.2, U1.3 (+), U4.3 (+)
/PRE_OUT: C9.1, R5.2, U1.1
/RESET: D6.3 (COM), R22.2, U2.4 (~RST)
/TIMING: C10.1, R10.2, U2.2 (TRIG), U2.6 (THRES), U3.3 (R)
/V555: C3.1, C18.1, D6.2 (K), R23.2, U2.8 (VCC)
/VB: R4.1, R29.2, RV1.1, RV4.2, RV6.2, RV6.3, U4.6 (-), U4.7
/VB_RAW: C4.1, R1.2, R2.1, U4.5 (+)
unnamed: C7.1, R6.2
unnamed: C12.2, R13.1
unnamed: C13.2, R12.1
unnamed: C14.2, R16.2, R18.1, U1.7
unnamed: C15.1, R17.2
unnamed: C16.1, R18.2
unnamed: C16.2, RV5.3
unnamed: C17.1, R25.2
unnamed: C20.2, R26.1
unnamed: D2.2 (A), R19.2
unnamed: D3.1 (K), D4.2 (A), R24.1, R25.1, U4.2 (-)
unnamed: D5.2 (A), U5.1
unnamed: D5.1 (K), R27.1
unnamed: Q1.1 (B), R33.2
unnamed: Q1.3 (C), U3.2 (K)
unnamed: Q1.2 (E), R32.2, R34.1
unnamed: R8.2, RV2.3
unnamed: R9.1, RV2.1
unnamed: R10.1, RV3.3
unnamed: R12.2, R14.1, RV4.3
unnamed: R13.2, R15.1, RV4.1
unnamed: R26.2, RV1.3
unnamed: R30.2, RV6.1
unnamed: R33.1, U5.7
unnamed: R20.1, SW1.1 (A)
unnamed: R21.2, SW1.3 (C)
unnamed: R5.1, R6.1, U1.2 (-)
unnamed: R14.2, R15.2, U1.5 (+)
unnamed: C14.1, R16.1, R17.1, U1.6 (-)
unnamed: C11.1, U2.5 (CONT)
unnamed: R35.2, U3.1 (A)
unnamed: RV1.2, U5.3 (+)
unnamed: R28.1, R29.1, U5.2 (-)
unnamed: R31.2, R32.1, R36.2, U5.6 (-)

Notes on the sheet:
envelope brightens LED -> pitch rises
U1A (gain 201) now drives only the gate and envelope.
POWER & BIAS
LDR (U3 pins 3-4) is in parallel with FREQUENCY:
THRESHOLD pot -> SW1 toggle (GATED / GLITCH / ON) + RV2 3362P trimmer; R13 47k (mix balance).
D6 BAT54S RESET clamp; R21 15k (THR ON lets the guitar through); R13 220k (MIX balance).
INPUT & PREAMP (U1A)
VACTROL DRIVER (U5B, Q1)
4. v1.1 (2026-10-03): C4 100u elec; R22 22k into RESET; C7 2.2u; R23/C18 555 supply filter; C12/C13 1u; U4A clean dry path; U4B VB buffer;
1. SMD passives 0805 (hand-solder pads) unless noted; C9 is 1206. LCSC field = JLCPCB part number.
2. Hand-soldered: RV1, RV3-RV5 (Alpha 16mm), RV2 (3362P trimmer), SW1 (Taiway 100 toggle), D2 (3mm LED), U3 (DIY vactrol), J1-J8 wire pads. D3/D4 optional (3 mm LEDs / 1N4148, not fitted).
R36: ~0.2 V dead zone, so the LED is fully off at rest
Gain = 1 + R5/R6 = 201 (46 dB)
GATED
VB = 4.5V virtual ground for U1
VOLUME
v1.3: from clean DRY_OUT
THRESHOLD
U5A peak detector x22
5. v1.3 (2026-10-16): new envelope (U5 LM358 detector + Q1 LED driver, fed from DRY_OUT; R7/C8 removed; RV1 A10k level; RV6 DECAY trim);
more envelope -> lower LDR R -> pitch rises
D1: reverse-polarity protection
DECAY
U4A: clean dry path for MIX (v1.1).
NOTES
~240 Hz tilt evens strings
OFF-BOARD WIRING
OSCILLATOR (U2 TLC555)
I_LED = 2.1 x (ENV - VB - 0.2 V) / R34, ~15 mA max
ENVELOPE
C7 2.2u (v1.1, was 10u): control-path LF corner ~72 Hz
ENVELOPE & GATE
FREQUENCY
MIX & OUTPUT (U1B)
D3/D4 not fitted: 3 mm LEDs or standing 1N4148s for a soft-clipped dry.
fully down = no envelope
LDR in parallel with FREQUENCY:
Output gain = 1 + R16/R17 = 4.1
U4B buffers VB (MIX pot wiper and the preamp bias return here)
MIX
3. Changes from Eagle v2: R16 feedback connected, RV3 pin 1 to DISCH, R7/R18/C3/C11 added, C7 220n->10u, C4 47u elec->22u MLCC.

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
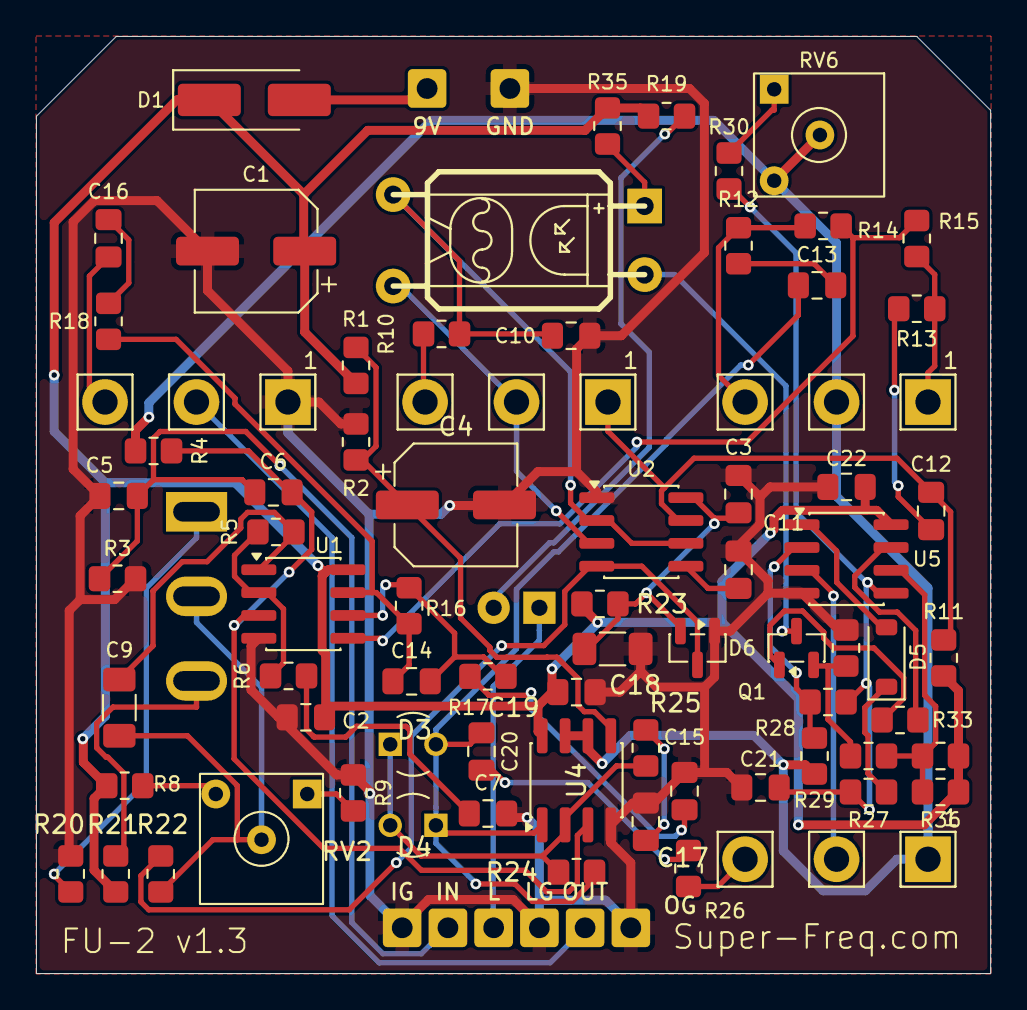
[picture p28: board UglyFace_03.kicad_pcb from above]

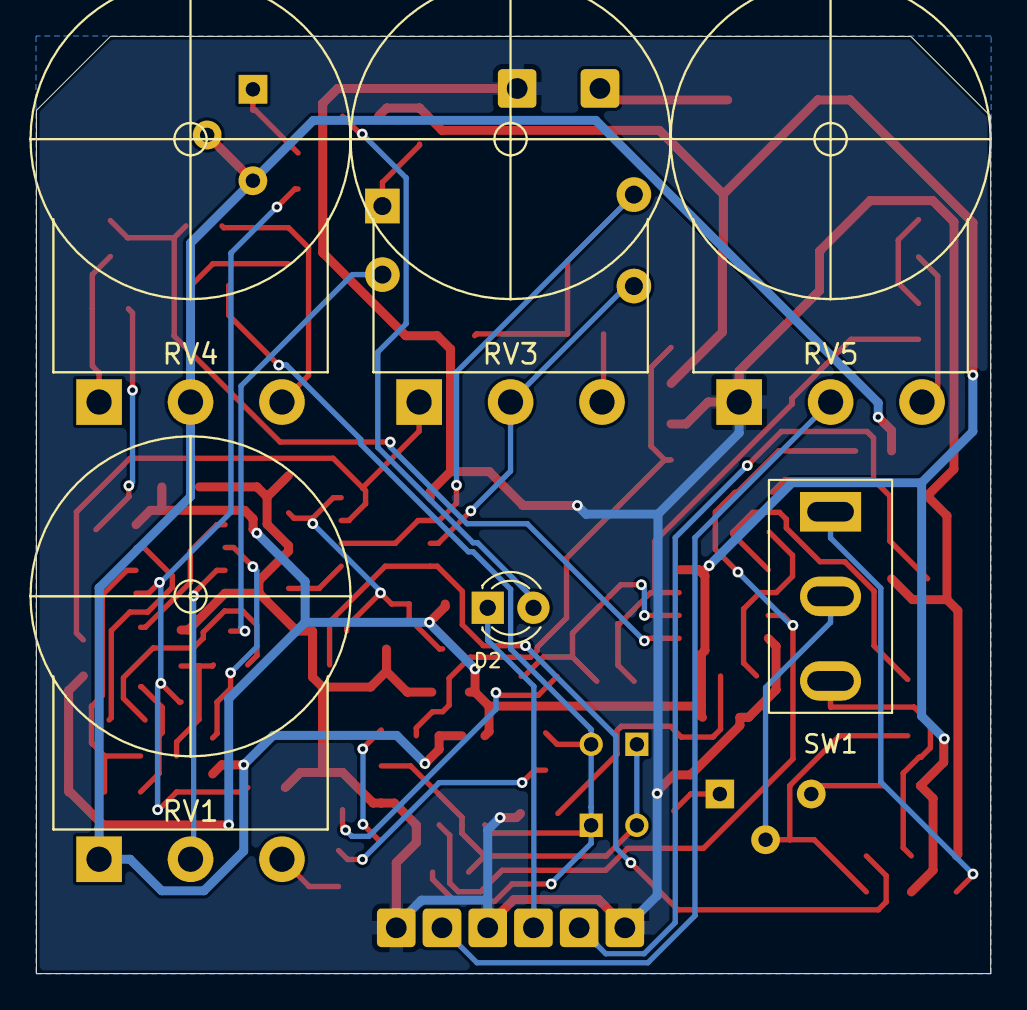
[picture p29: board UglyFace_03.kicad_pcb from below]

Board: 2 copper layers, 53.0 x 52.1 mm, 84 parts (3 on the bottom side), 52 nets.

Other parts of the board:
ENC1: Hammond 1590B; Hammond_1590B
