soggybag/Ugly-Face-3-SMD/(commit log)

2026-10-03 Ugly Face 3 SMD: KiCad project, docs and bench results
    KiCad 10 project (TL072 + TLC555 with MIX, 1590B; silk "Deformis v2")
    as ordered from JLCPCB, with project-local footprints and 3D models,
    schematic/layout PDFs, renders, the bench test procedure and results,
    build notes (C4 fix, timing-cap derating, CMOS protection) and the
    Ugly Face family roadmap.
    [1590B.stp, RV16AF-41.step, UglyFace_03.kicad_pcb, UglyFace_03.kicad_sch]
2026-10-07 Ugly Face 3 v1.1: C4 100u, RESET 22k, filtered 555 supply, clean dry path, buffered VB, THRESHOLD toggle, GLITCH trimmer, D3/D4 LED pads
    As ordered from JLCPCB (October 2026 batch).
    [UglyFace_03.kicad_pcb, UglyFace_03.kicad_sch]
2026-10-07 Archive v1.0 and v1.1: schematic and board PDFs, renders, interactive BOM, parts list, docs and fab files
    [UglyFace_03_hand_solder.csv, bom.csv, designators.csv, parts.csv, positions.csv]
2026-10-07 Archive v1.0 fab files
    [UglyFace_03_BOM_JLCPCB.csv, UglyFace_03_hand_solder.csv, bom.csv, designators.csv, positions.csv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]
2026-10-16 UF3 v1.1: 1590B drill guide (Tayda CSV, printable template, Othermill marks)
    [UglyFace3_1590B_drill.csv]
2026-10-16 UF3 v1.1: bench results, notes for building leftover boards, envelope roadmap
2026-10-17 UF3 v1.3: new envelope design (clean DRY_OUT sidechain, LM358 detector + current-sink LED driver), ngspice sim, MIX notes
2026-10-17 UF3 schematic rev 1.3: new envelope (U5 LM358 detector from DRY_OUT, Q1 vactrol current sink, DECAY trim), D6 BAT54S RESET clamp, R21 15k, R13 220k; R7/C8 removed
    [UglyFace_03.kicad_sch]
2026-10-20 UF3 v1.3 PCB: new envelope parts placed and routed, slotted Taiway footprint, R31/R32 Basic 100k; renders, schematic PDF, docs
    Board synced to schematic rev 1.3 (U5, Q1, D5, D6, C20-C22, R26-R36, RV6 added; R7, C8 removed; R13 220k, R21 15k, RV1 A10k).
    Fully routed (46 vias), DRC 0 errors, parity clean. Envelope not breadboarded yet.
    [UglyFace_03.kicad_pcb, UglyFace_03.kicad_sch]
2026-10-24 v1.3 = FU-2: silk 'FU-2 v1.3', R8 47k (Basic), C21 4.7u (bench-tested envelope), schematic title; envelope breadboard sheet; docs, renders
    [UglyFace_03.kicad_pcb, UglyFace_03.kicad_sch]
2026-10-24 Archive v1.3 (FU-2): schematic and board PDFs, renders, interactive BOM, parts list, docs and fab files
    [UglyFace3_1590B_drill.csv, UglyFace_03_hand_solder.csv, bom.csv, designators.csv, parts.csv, positions.csv]
